PrimeBuild-pc/MouseLatencyTester/docs/images/README.md

# Screenshots

Place interface screenshots here and reference them from the main `README.md`.

Suggested set (generate them with **Settings → Demo mode → Start demo device**
so no hardware is needed and no real data is exposed):

| File | Content |
|---|---|
| `live-dark.png` | Live test tab, dark theme, mid-run |
| `live-light.png` | Live test tab, light theme |
| `testmode-green.png` | Full-screen test mode, armed state |
| `compare-box.png` | Compare tab, box plot of 4 polling rates |
| `compare-ecdf.png` | Compare tab, ECDF |
| `sessions.png` | Archive with search |
| `wiring.jpg` | Photo of the actual probe setup |

Keep them under ~500 KB each.
