PrimeBuild-pc/MouseLatencyTester/docs/hardware/teensy20-dimensions.png

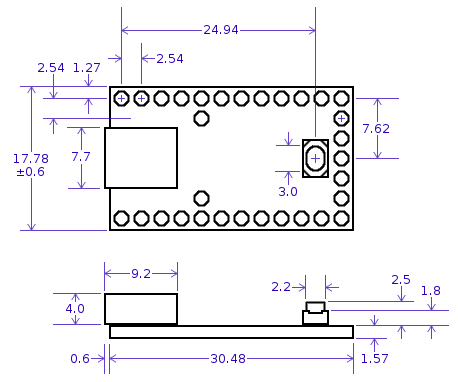
docs/hardware/teensy20-dimensions.png
