PrimeBuild-pc/MouseLatencyTester/docs/images/hardware/pcb-a1b-bottom.png

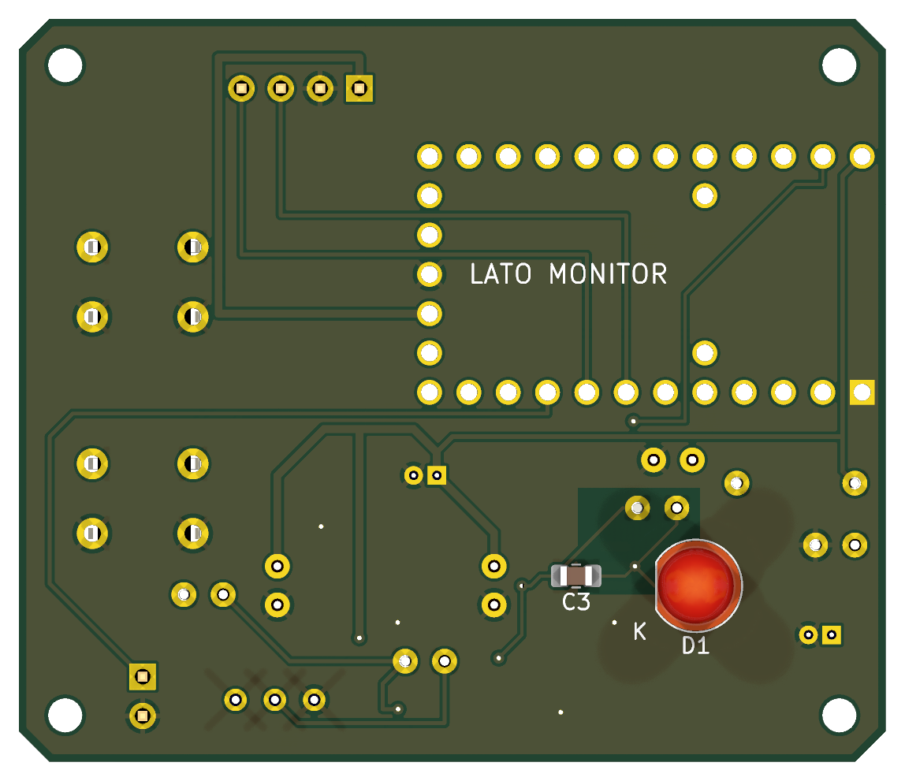
docs/images/hardware/pcb-a1b-bottom.png
