PrimeBuild-pc/MouseLatencyTester/docs/images/hardware/pcb-a1b-top.png

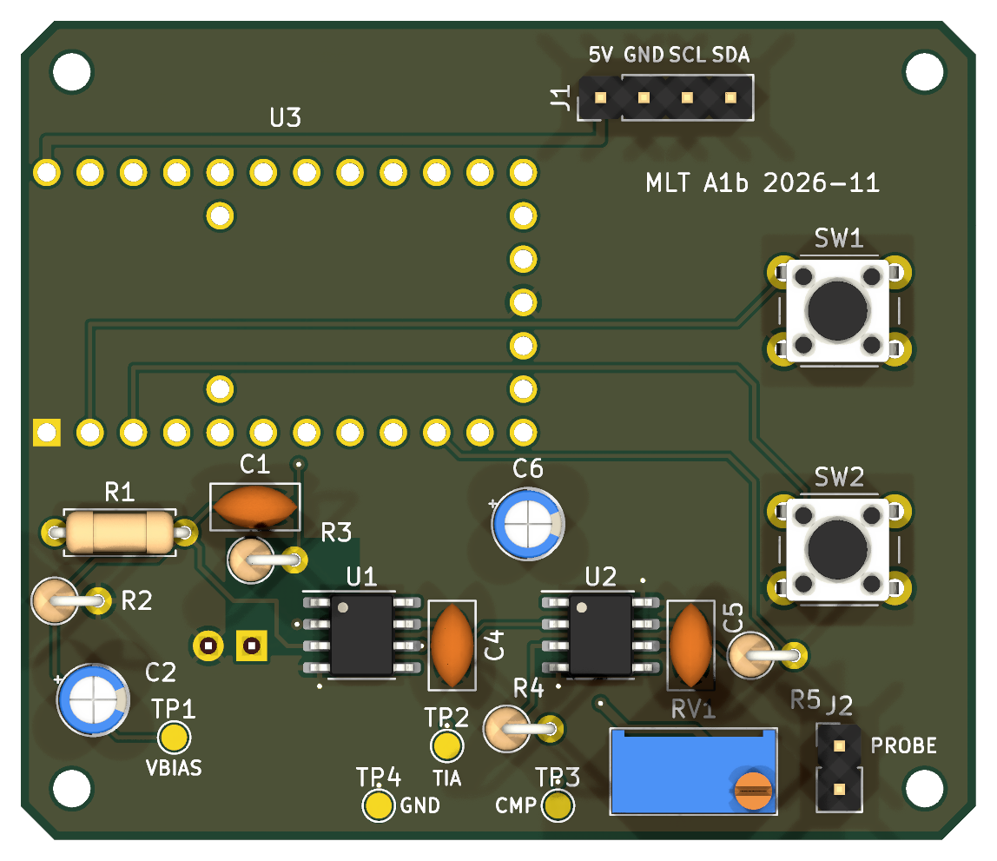
docs/images/hardware/pcb-a1b-top.png
