PrimeBuild-pc/MouseLatencyTester/hardware/compact/board-first.png

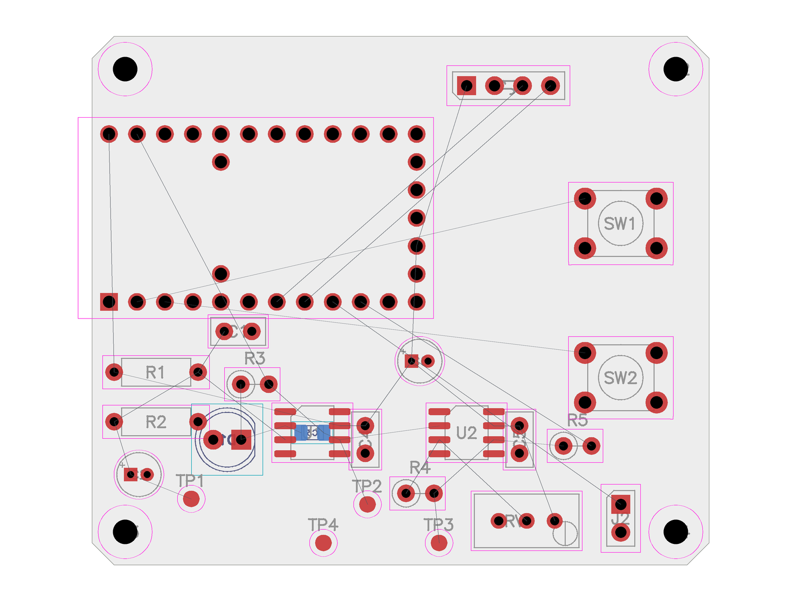
hardware/compact/board-first.png
