PrimeBuild-pc/MouseLatencyTester/hardware/compact/board-top.png

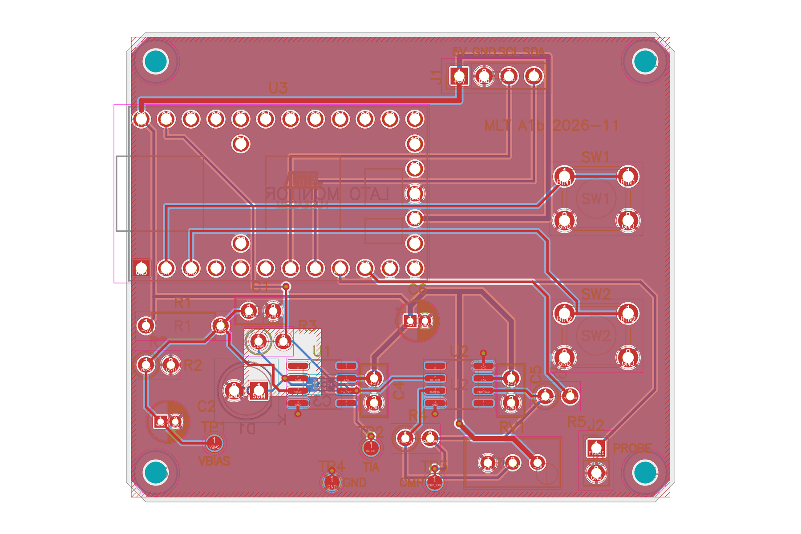
hardware/compact/board-top.png
