PrimeBuild-pc/MouseLatencyTester/hardware/compact/gerber-bottom.png

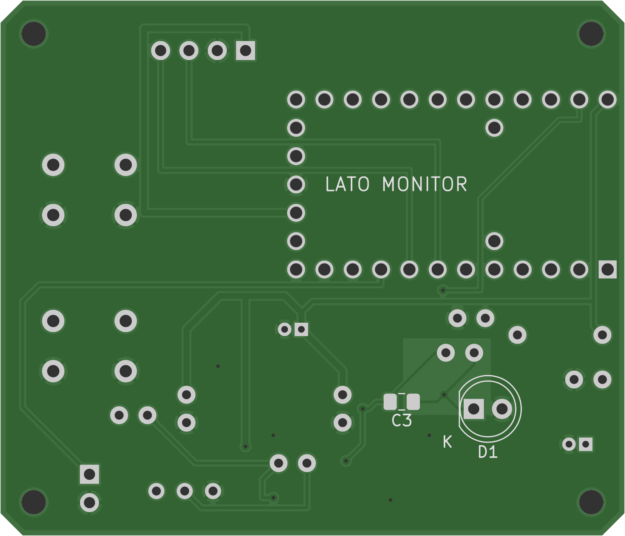
hardware/compact/gerber-bottom.png
