PrimeBuild-pc/MouseLatencyTester/hardware/compact/placement.png

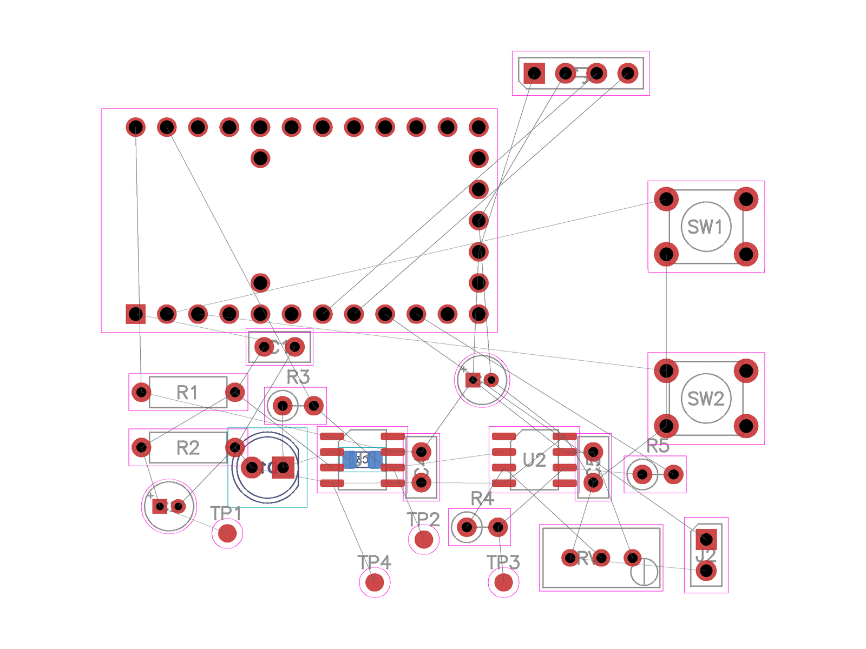
hardware/compact/placement.png
