PrimeBuild-pc/MouseLatencyTester/hardware/compact/preview-complete.png

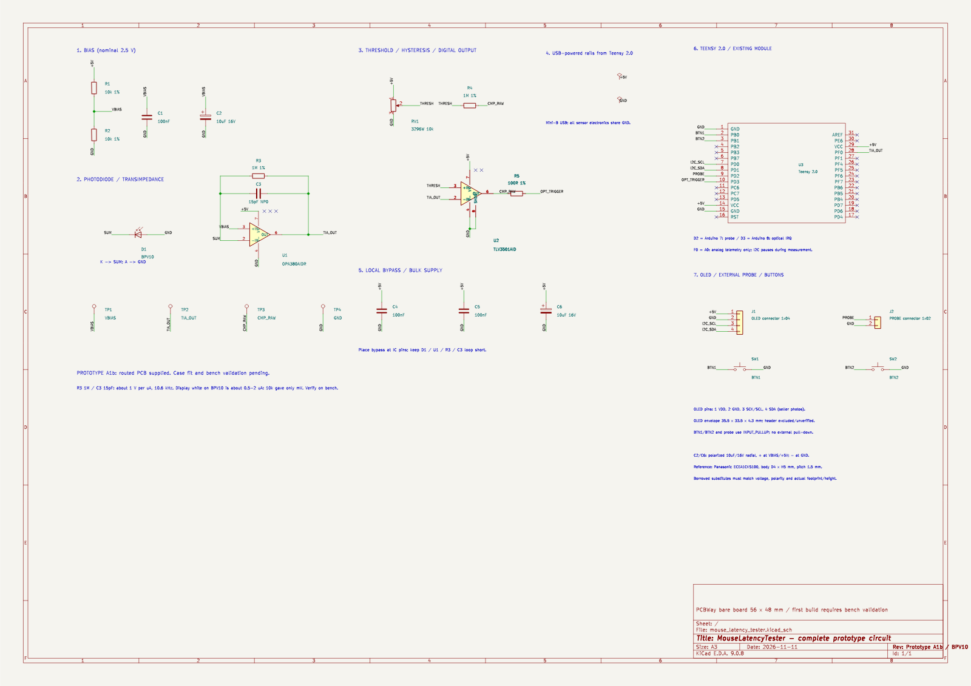
hardware/compact/preview-complete.png
