PrimeBuild-pc/MouseLatencyTester/hardware/optical-front-end/preview.png

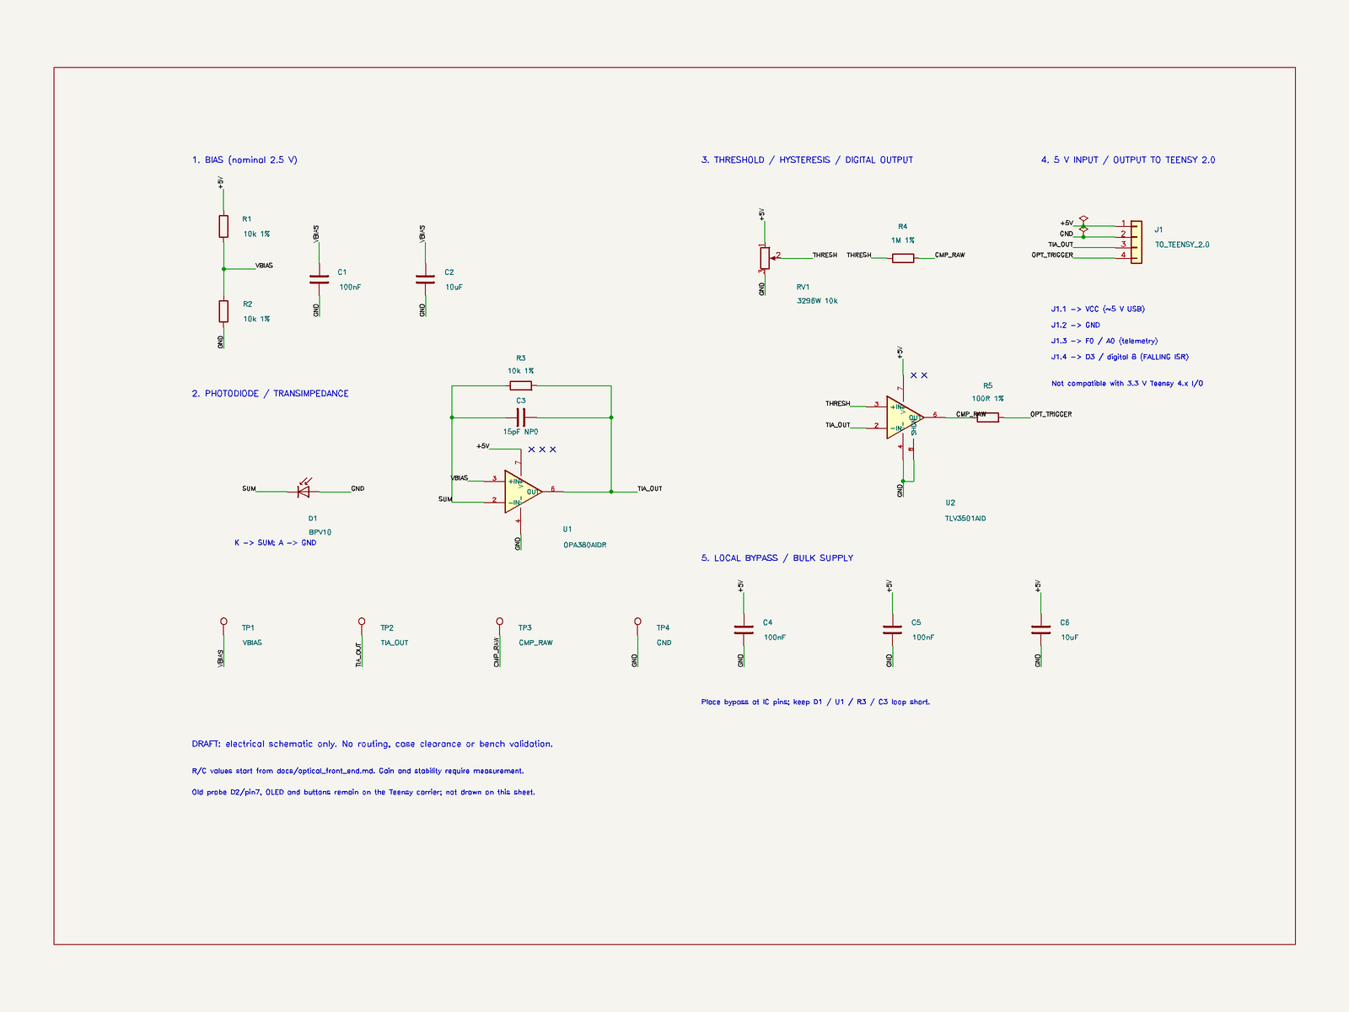
hardware/optical-front-end/preview.png
