PrimeBuild-pc/MouseLatencyTester/hardware/compact/mechanical/mouse_latency_tester.step

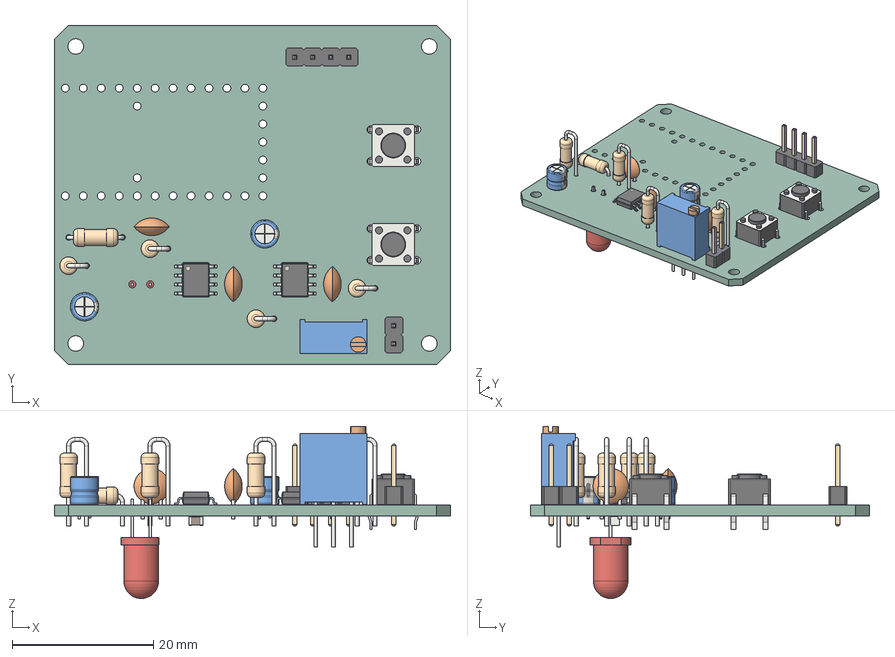
[picture p25: CAD file, 2026-11-11]
hardware/compact/mechanical/mouse_latency_tester.step
56.0 x 48.0 x 24.3 mm
C_Disc_D50mm_W25mm_P250mm x 3
R_Axial_DIN0207_L63mm_D25mm_P762mm_Horizontal
SW_PUSH_6mm_h4.3mm x 2
SOIC-8_3.9x4.9mm_P1.27mm x 2
R_Axial_DIN0207_L63mm_D25mm_P254mm_Vertical x 4
PinHeader_1x02_P254mm_Vertical
CP_Radial_D40mm_P150mm x 2
PinHeader_1x04_P254mm_Vertical
Potentiometer_Bourns_3296W_Vertical
LED_D5.0mm
C_0805_2012Metric
mouse_latency_tester_PCB
