PrimeBuild-pc/MouseLatencyTester/outputs/MouseLatencyTester-A1/Delivery-A1/Mechanical/mouse_latency_tester-outline.dxf

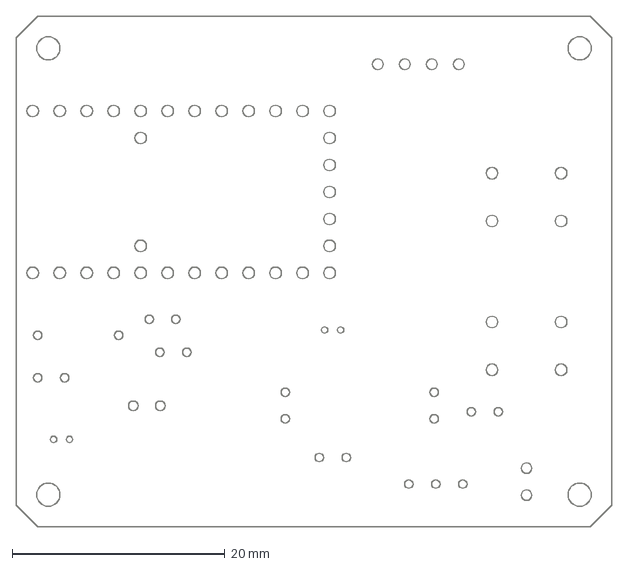
[picture p26: CAD file, 2026-11-11]
outputs/MouseLatencyTester-A1/Delivery-A1/Mechanical/mouse_latency_tester-outline.dxf
56.0 x 48.0 mm
