PrimeBuild-pc/MouseLatencyTester/outputs/MouseLatencyTester-A1/Delivery-A1/Previews/assembly-top.png

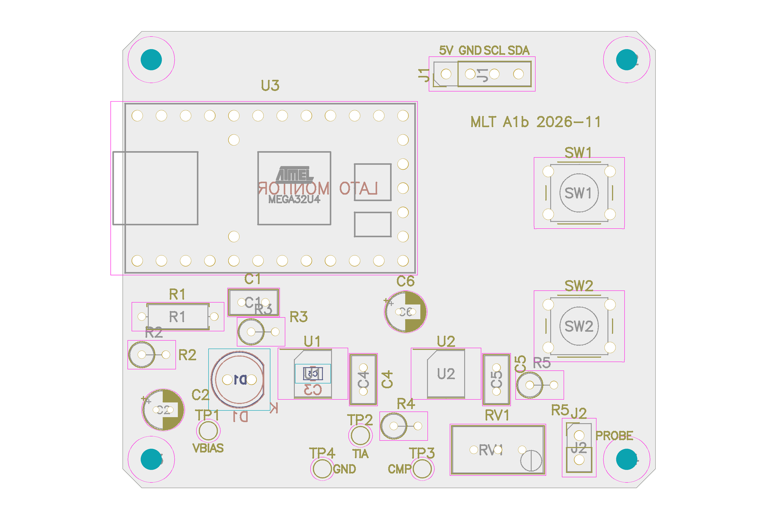
outputs/MouseLatencyTester-A1/Delivery-A1/Previews/assembly-top.png
