PrimeBuild-pc/MouseLatencyTester/hardware/compact/mouse_latency_tester.kicad_pcb

## KiCad design hardware/compact/mouse_latency_tester.kicad_pcb (2026-11-11)

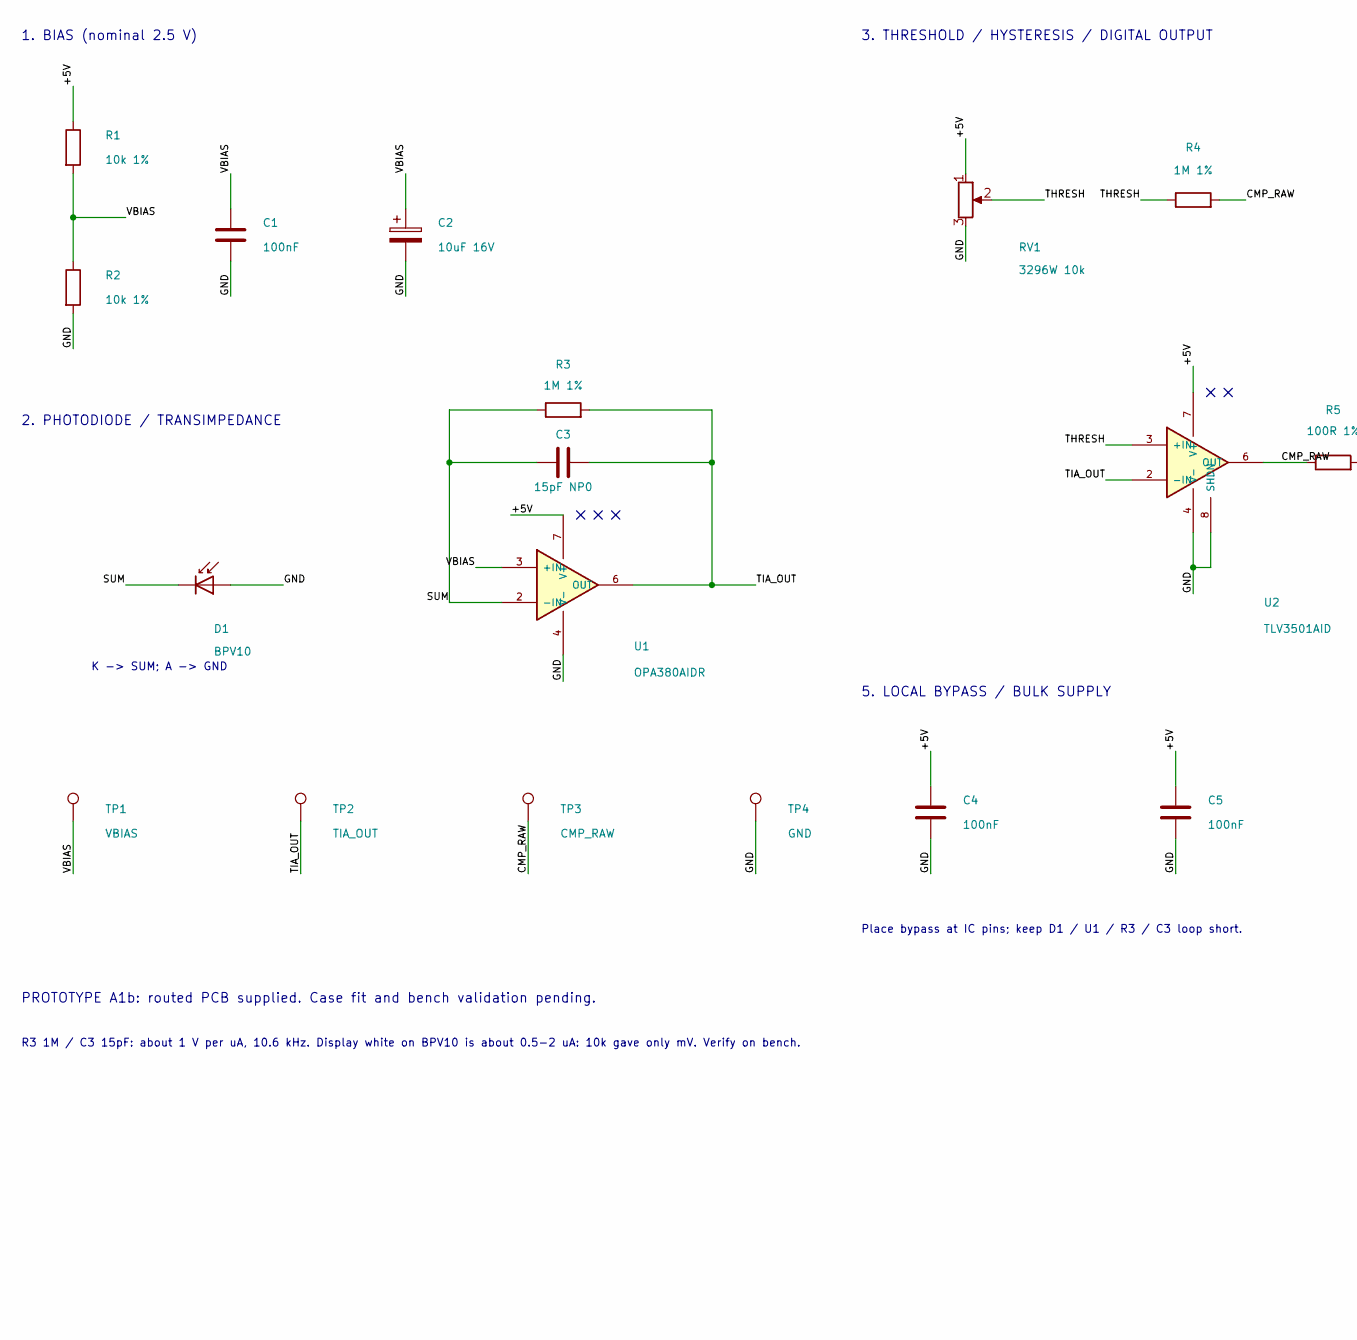
[picture p29: schematic mouse_latency_tester.kicad_sch, MouseLatencyTester - complete prototype circuit, part in row 1, column 1]

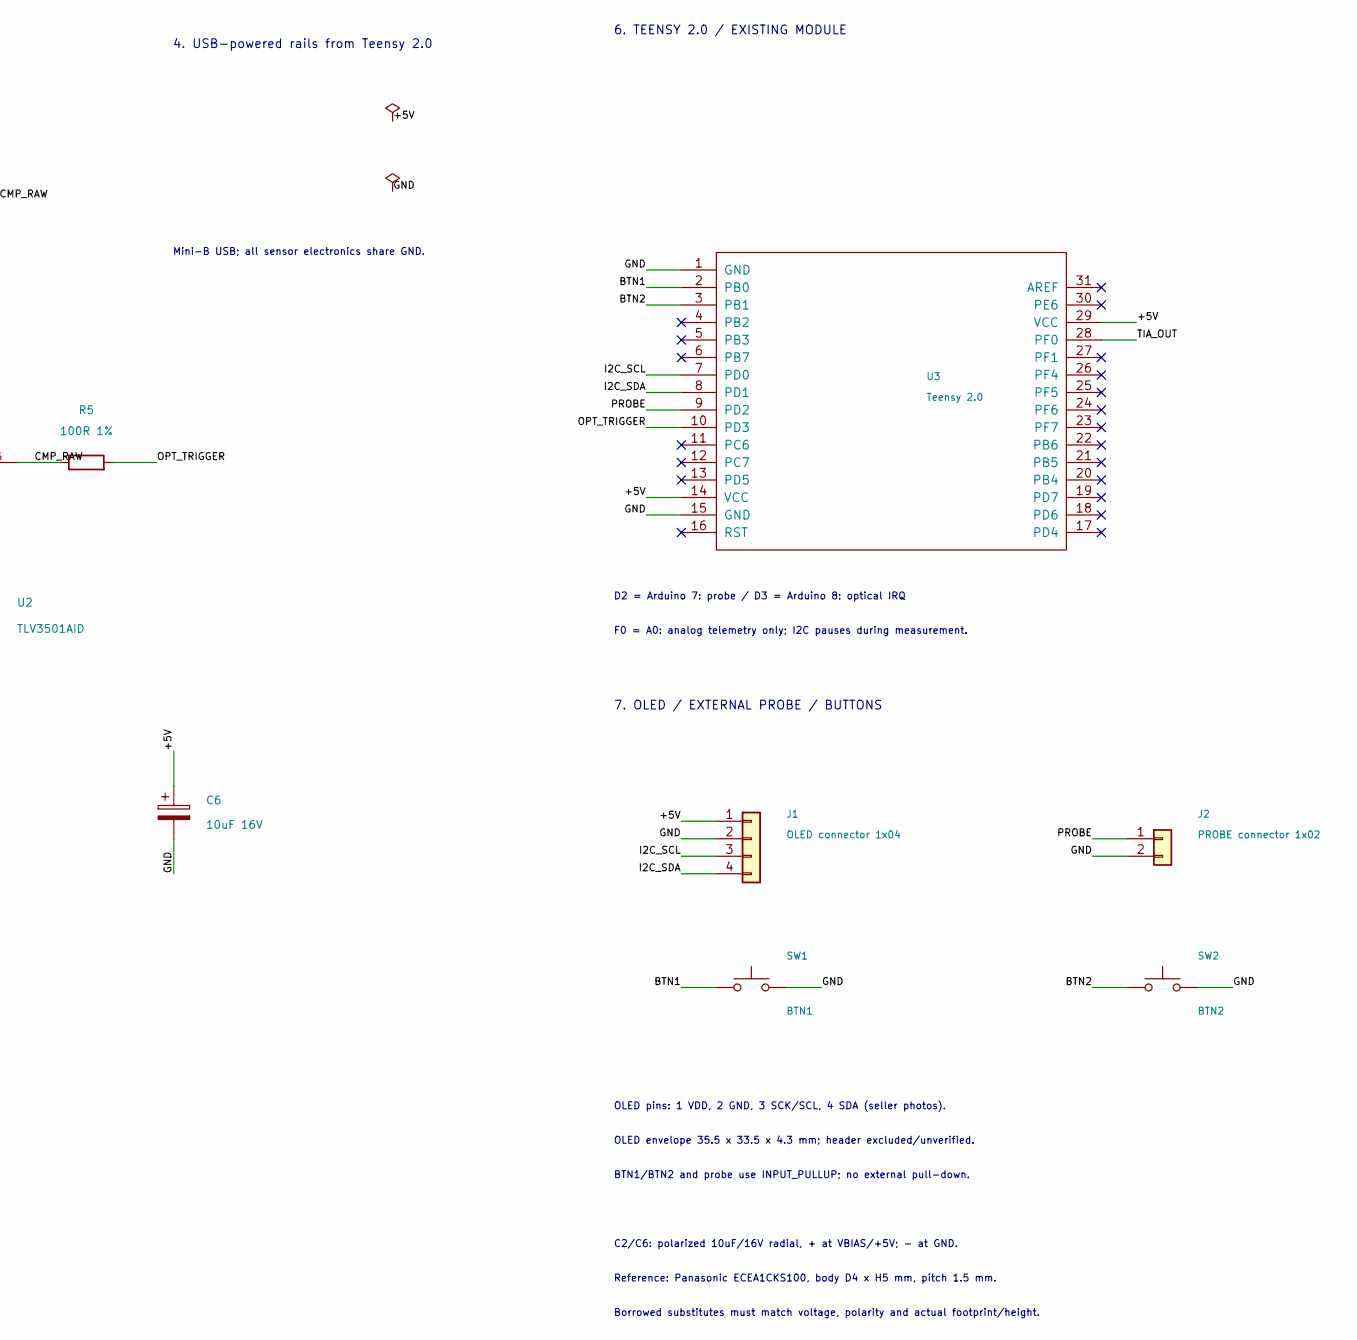
[picture p30: schematic mouse_latency_tester.kicad_sch, MouseLatencyTester - complete prototype circuit, part in row 1, column 2]

Parts:
C1, C4, C5: 100nF; C_Disc_D5.0mm_W2.5mm_P2.50mm
C2, C6: 10uF 16V; CP_Radial_D4.0mm_P1.50mm; MPN ECEA1CKS100
C3: 15pF NP0; C_0805_2012Metric_Pad1.18x1.45mm_HandSolder
D1: BPV10; LED_D5.0mm; MPN BPV10
J1: OLED connector 1x04; PinHeader_1x04_P2.54mm_Vertical
J2: PROBE connector 1x02; PinHeader_1x02_P2.54mm_Vertical
R1: 10k 1%; R_Axial_DIN0207_L6.3mm_D2.5mm_P7.62mm_Horizontal
R2: 10k 1%; R_Axial_DIN0207_L6.3mm_D2.5mm_P2.54mm_Vertical
R3, R4: 1M 1%; R_Axial_DIN0207_L6.3mm_D2.5mm_P2.54mm_Vertical
R5: 100R 1%; R_Axial_DIN0207_L6.3mm_D2.5mm_P2.54mm_Vertical
RV1: 3296W 10k; Potentiometer_Bourns_3296W_Vertical
SW1: BTN1; SW_PUSH_6mm_H4.3mm
SW2: BTN2; SW_PUSH_6mm_H4.3mm
TP1: VBIAS; TestPoint_Pad_D1.5mm
TP2: TIA_OUT; TestPoint_Pad_D1.5mm
TP3: CMP_RAW; TestPoint_Pad_D1.5mm
TP4: GND; TestPoint_Pad_D1.5mm
U1: OPA380AIDR; SOIC-8_3.9x4.9mm_P1.27mm; MPN OPA380AIDR
U2: TLV3501AID; SOIC-8_3.9x4.9mm_P1.27mm; MPN TLV3501AID
U3: Teensy 2.0; Teensy2.0; MPN Teensy 2.0

Connections:
/+5V: C4.1, C5.1, C6.1, J1.1, R1.1, RV1.1, U1.7 (V+), U2.7 (V+), U3.14 (VCC), U3.29 (VCC)
/BTN1: SW1.1, U3.2 (PB0)
/BTN2: SW2.1, U3.3 (PB1)
/CMP_RAW: R4.2, R5.1, TP3.1 (1_1), U2.6 (OUT)
/GND: C1.2, C2.2, C4.2, C5.2, C6.2, D1.2 (A), J1.2, J2.2, R2.2, RV1.3, SW1.2, SW2.2, TP4.1 (1_1), U1.4 (V-), U2.4 (V-), U2.8 (SHDN), U3.1 (GND), U3.15 (GND)
/I2C_SCL: J1.3, U3.7 (PD0)
/I2C_SDA: J1.4, U3.8 (PD1)
/OPT_TRIGGER: R5.2, U3.10 (PD3)
/PROBE: J2.1, U3.9 (PD2)
/SUM: C3.1, D1.1 (K), R3.1, U1.2 (-IN)
/THRESH: R4.1, RV1.2, U2.3 (+IN)
/TIA_OUT: C3.2, R3.2, TP2.1 (1_1), U1.6 (OUT), U2.2 (-IN), U3.28 (PF0)
/VBIAS: C1.1, C2.1, R1.2, R2.1, TP1.1 (1_1), U1.3 (+IN)

Notes on the sheet:
1. BIAS (nominal 2.5 V)
2. PHOTODIODE / TRANSIMPEDANCE
K -> SUM; A -> GND
3. THRESHOLD / HYSTERESIS / DIGITAL OUTPUT
5. LOCAL BYPASS / BULK SUPPLY
Place bypass at IC pins; keep D1 / U1 / R3 / C3 loop short.
PROTOTYPE A1b: routed PCB supplied. Case fit and bench validation pending.
R3 1M / C3 15pF: about 1 V per uA, 10.6 kHz. Display white on BPV10 is about 0.5-2 uA: 10k gave only mV. Verify on bench.
4. USB-powered rails from Teensy 2.0
Mini-B USB; all sensor electronics share GND.
6. TEENSY 2.0 / EXISTING MODULE
D2 = Arduino 7: probe / D3 = Arduino 8: optical IRQ
F0 = A0: analog telemetry only; I2C pauses during measurement.
7. OLED / EXTERNAL PROBE / BUTTONS
OLED pins: 1 VDD, 2 GND, 3 SCK/SCL, 4 SDA (seller photos).
OLED envelope 35.5 x 33.5 x 4.3 mm; header excluded/unverified.
BTN1/BTN2 and probe use INPUT_PULLUP; no external pull-down.
C2/C6: polarized 10uF/16V radial, + at VBIAS/+5V; - at GND.
Reference: Panasonic ECEA1CKS100, body D4 x H5 mm, pitch 1.5 mm.
Borrowed substitutes must match voltage, polarity and actual footprint/height.

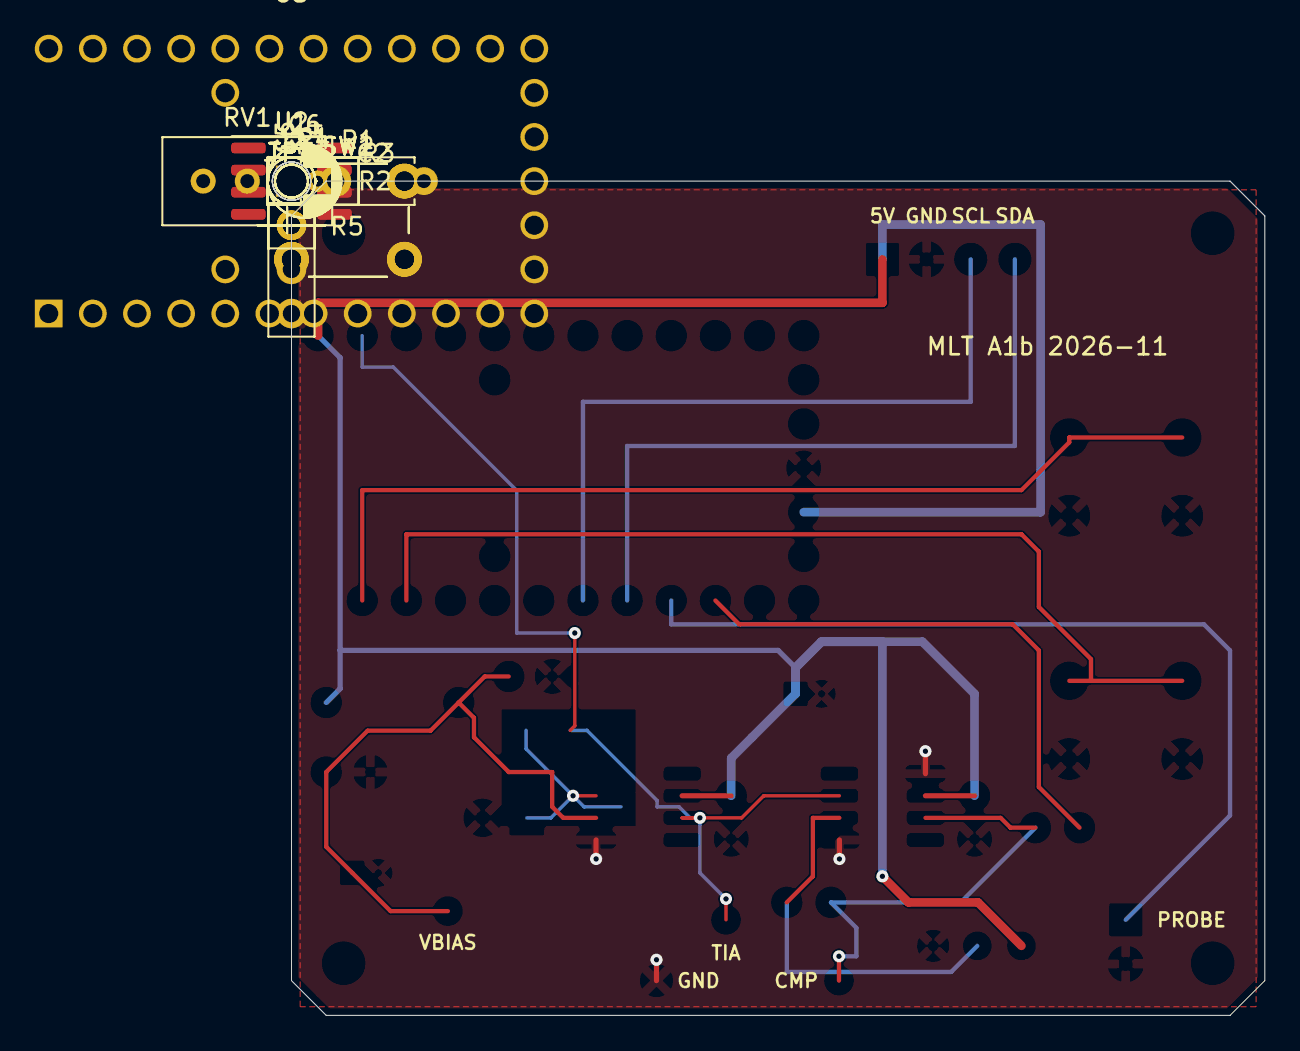
[picture p31: board mouse_latency_tester.kicad_pcb from above]

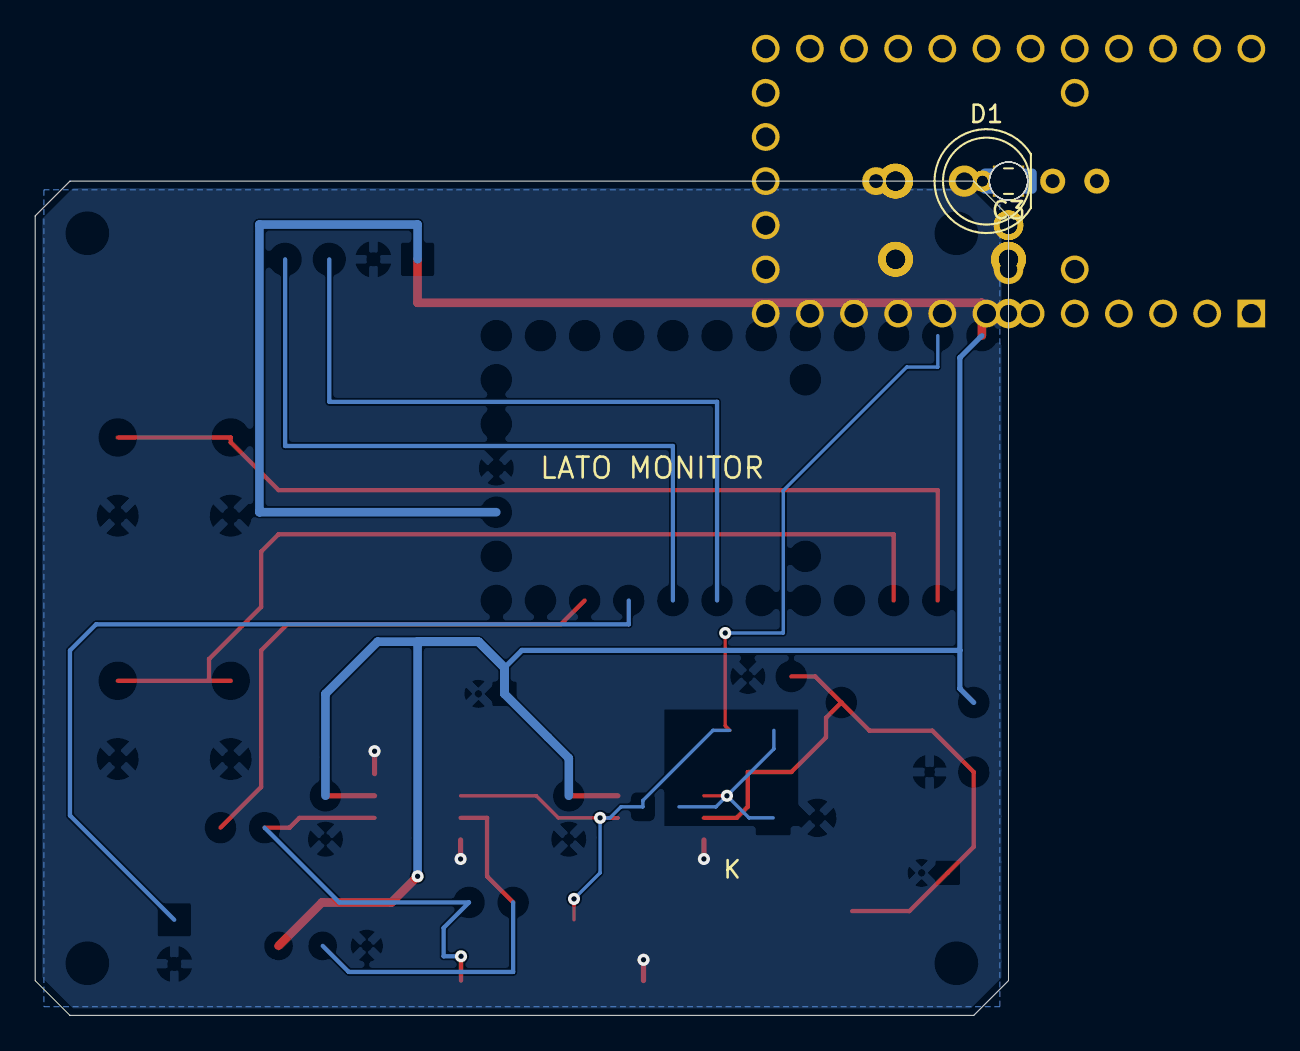
[picture p32: board mouse_latency_tester.kicad_pcb from below]

Board: 2 copper layers, 56.0 x 48.0 mm, 28 parts (2 on the bottom side), 13 nets.

Other parts of the board:
H1, H2, H3, H4: MountingHole_2.2mm_M2
