PrimeBuild-pc/MouseLatencyTester/latency_tester/app.py

"""Application shell: owns the services, the state and the event pump.

Threading rule: only this module's ``_pump`` touches tkinter.  The serial
reader thread and the mouse callback communicate exclusively through the event
queue in :mod:`latency_tester.serial_service`.
"""

from __future__ import annotations

import logging
import queue
import tkinter as tk
from datetime import datetime
from tkinter import filedialog, messagebox, ttk

from . import SUPPORTED_FIRMWARE, __version__, export, protocol, serial_service, theme
from .constants import (FRAME_CAP_AUTO, FRAME_CAP_FALLBACK, MEASUREMENT_MODES,
                        MODE_PHOTON, MODE_PROBE_PC)
from .database import LatencyDB
from .demo import PORT_NAME as DEMO_PORT
from .demo import DemoDevice
from .i18n import translator as tr
from .settings import Settings
from .stats import compute_stats, fmt_ms

log = logging.getLogger(__name__)

PUMP_INTERVAL_MS = 50
LIGHT_POLL_MS = 1000
#: Faster reading while the optical calibration target is showing.
LIGHT_AIM_POLL_MS = 150
#: How long to let the LDR settle after the target changes colour, before a
#: baseline is sampled.  A photoresistor is slow; this is not a guess to tune
#: away, it is the sensor's own response time.
OPTICAL_SETTLE_MS = 400
#: The optical calibration, in order: (target is bright, command to send).
PHOTON_CALIBRATION_STEPS = (
    (False, protocol.CMD_CAL_DARK),
    (True, protocol.CMD_CAL_BRIGHT),
)
RECONNECT_INTERVAL_MS = 3000

class LatencyTesterApp:
    def __init__(self, root: tk.Tk):
        self.root = root

        self.settings = Settings()
        tr.set_language(self.settings.get("language"))
        self.palette = theme.resolve(self.settings.get("theme"))

        self.db = LatencyDB(self.settings.db_path)
        if not self.db.list_devices():
            self.db.create_device(name="Mouse")

        self.serial = serial_service.SerialService()
        self.serial.accept_trig = self._accept_trig
        self.mouse = serial_service.MouseWatcher(self.serial.clicks)
        self.mouse.start()

        self.running = True
        self.test_mode = False
        self.test_complete = False
        self.overlay = None
        self.cal_window = None
        self._reconnect_port: str | None = None

        # Current, unsaved run.
        self.current_samples: list[dict] = []
        self.session_saved = False
        self.run_started_at: str | None = None
        self.run_ended_at: str | None = None
        self.test_start_index = 0
        self.current_light: int | None = None
        self.light_start: int | None = None
        self.light_end: int | None = None
        self._awaiting_light_end = False

        self._build_vars()
        self._build_shell()

        self.auto_select_device()
        self.refresh_ports(auto_connect=bool(self.settings.get("auto_connect")))
        # Tracked so shutdown can cancel them; a callback firing after the
        # interpreter is gone raises "invalid command name" out of Tk itself.
        self._timers = {
            "pump": self.root.after(PUMP_INTERVAL_MS, self._pump),
            "light": self.root.after(LIGHT_POLL_MS, self._poll_light),
            "watch": self.root.after(RECONNECT_INTERVAL_MS, self._watch_connection),
        }
        self.root.protocol("WM_DELETE_WINDOW", self.close)

    # ================================================================ state ==
    def _build_vars(self) -> None:
        s = self.settings
        self.port_var = tk.StringVar()
        self.connection_var = tk.StringVar(value=tr("conn.disconnected"))
        self.firmware_var = tk.StringVar(value="—")
        self.state_var = tk.StringVar(value="READY")
        self.cal_var = tk.StringVar(value="0 µs")
        self.light_var = tk.StringVar(value="—")
        self.skipped_var = tk.StringVar(value="0")
        # Firmware v1.4 button test: counters make "10 presses -> 10 events"
        # verifiable at a glance.
        self.button_counts = {1: 0, 2: 0}
        self.button_vars = {1: tk.StringVar(value="0"), 2: tk.StringVar(value="0")}

        self.metric_vars = {
            key: tk.StringVar(value="—")
            for key in ("last", "mean", "median", "min", "max", "stdev",
                        "p5", "p95", "p99", "iqr", "mad", "jitter")
        }
        self.metric_vars["n"] = tk.StringVar(value="0")
        self.outlier_var = tk.StringVar(value="")

        self.device_var = tk.StringVar()
        self.run_name_var = tk.StringVar()
        self.polling_var = tk.StringVar(value=str(s.get("last_polling_rate")))
        self.mode_var = tk.StringVar(value=str(s.get("last_connection_mode")))
        self.dpi_var = tk.StringVar(value=str(s.get("last_dpi") or ""))
        self.mouse_fw_var = tk.StringVar()
        self.debounce_var = tk.StringVar()
        self.notes_var = tk.StringVar()
        self.target_var = tk.IntVar(value=int(s.get("target_samples") or 50))
        self.auto_reset_var = tk.BooleanVar(value=bool(s.get("auto_reset_on_test")))

        self.language_var = tk.StringVar(value=tr.language)
        self.theme_var = tk.StringVar(value=str(s.get("theme")))
        self.auto_connect_var = tk.BooleanVar(value=bool(s.get("auto_connect")))
        self.confirm_btn2_var = tk.BooleanVar(value=bool(s.get("confirm_btn2_reset")))

        # Probe-to-Photon.  The mode is a plain string so it can go straight
        # into the archive; MEASUREMENT_MODES is the only accepted vocabulary.
        mode = s.get("measurement_mode")
        self.measure_mode_var = tk.StringVar(
            value=mode if mode in MEASUREMENT_MODES else MODE_PROBE_PC)
        self.optical_dark: int | None = None
        self.optical_bright: int | None = None
        self.optical_threshold: int | None = None
        self.optical_rising = True
        self.opt_dark_var = tk.StringVar(value="—")
        self.opt_bright_var = tk.StringVar(value="—")
        self.opt_threshold_var = tk.StringVar(value="—")
        self.opt_status_var = tk.StringVar(value=tr("photon.status_uncalibrated"))
        # Frame cap for the optical target.  FRAME_CAP_AUTO means "whatever the
        # monitor is running at", resolved when a test starts rather than now:
        # the user may move the window to another screen in between.
        self.frame_cap = _as_int(s.get("frame_cap"), FRAME_CAP_AUTO)
        self.frame_cap_var = tk.StringVar()

        self.device_name_to_id: dict[str, int] = {}

    # ================================================================ shell ==
    def _build_shell(self) -> None:
        theme.apply(self.root, self.palette)
        self.root.title(f"{tr('app.title')} v{__version__}")
        geometry = str(self.settings.get("window_geometry") or "")
        self.root.geometry(geometry if geometry else "1380x900")
        self.root.minsize(1024, 680)

        self.shell = ttk.Frame(self.root, padding=12)
        self.shell.pack(fill="both", expand=True)

        self._build_connection_bar(self.shell)

        self.demo_banner = ttk.Label(self.shell, text=tr("app.demo_banner"),
                                     style="Demo.TLabel")
        # packed/unpacked by _update_connection_labels

        self.notebook = ttk.Notebook(self.shell)
        self.notebook.pack(fill="both", expand=True, pady=(10, 0))

        from .views.compare import CompareView
        from .views.devices import DevicesView
        from .views.live import LiveView
        from .views.preferences import PreferencesView
        from .views.sessions import SessionsView

        self.live_view = LiveView(self.notebook, self)
        self.sessions_view = SessionsView(self.notebook, self)
        self.compare_view = CompareView(self.notebook, self)
        self.devices_view = DevicesView(self.notebook, self)
        self.preferences_view = PreferencesView(self.notebook, self)

        self.notebook.add(self.live_view, text=tr("tab.live"))
        self.notebook.add(self.sessions_view, text=tr("tab.sessions"))
        self.notebook.add(self.compare_view, text=tr("tab.compare"))
        self.notebook.add(self.devices_view, text=tr("tab.devices"))
        self.notebook.add(self.preferences_view, text=tr("tab.settings"))

        self.refresh_devices()
        self.refresh_sessions()
        self._update_metrics()
        self._update_connection_labels()

    def _build_connection_bar(self, parent: ttk.Frame) -> None:
        bar = ttk.LabelFrame(parent, text=f" {tr('conn.title')} ", padding=10)
        bar.pack(fill="x")

        ttk.Label(bar, text=tr("conn.port")).pack(side="left")
        self.port_combo = ttk.Combobox(bar, textvariable=self.port_var,
                                       width=34, state="readonly")
        self.port_combo.pack(side="left", padx=(8, 8))
        ttk.Button(bar, text=tr("conn.refresh"),
                   command=lambda: self.refresh_ports(False)).pack(side="left", padx=3)
        self.connect_btn = ttk.Button(bar, text=tr("conn.connect"),
                                      command=self.toggle_connection,
                                      style="Accent.TButton")
        self.connect_btn.pack(side="left", padx=3)

        ttk.Separator(bar, orient="vertical").pack(side="left", fill="y", padx=14)
        ttk.Label(bar, text=tr("conn.status")).pack(side="left", padx=(0, 6))
        self.connection_label = ttk.Label(bar, textvariable=self.connection_var,
                                          style="Error.TLabel")
        self.connection_label.pack(side="left")
        ttk.Label(bar, text=tr("conn.firmware"),
                  style="Muted.TLabel").pack(side="left", padx=(16, 6))
        ttk.Label(bar, textvariable=self.firmware_var).pack(side="left")

        ttk.Label(bar, text=f"{tr('conn.archive')}: {self.db.path}",
                  style="Muted.TLabel").pack(side="right")

    def rebuild_ui(self) -> None:
        """Re-create the interface after a theme or language change."""
        if self.test_mode:
            return
        self.settings.save()
        self.palette = theme.resolve(self.settings.get("theme"))
        self.shell.destroy()
        self._build_shell()
        self.live_view.set_samples(self._latencies())
        self._update_metrics()

    # =========================================================== connection ==
    def refresh_ports(self, auto_connect: bool = False) -> None:
        ports = serial_service.list_ports()
        labels = [p["label"] for p in ports]
        labels.append(DEMO_PORT)
        self.port_combo["values"] = labels

        detected = next((p["label"] for p in ports if p["is_teensy"]), None)
        if detected:
            self.port_var.set(detected)
        elif not self.port_var.get() and labels:
            self.port_var.set(labels[0])

        if auto_connect and detected and not self.serial.connected:
            self.root.after(250, lambda: self._auto_connect(attempts=4))

    def _auto_connect(self, attempts: int) -> None:
        """Connect at startup without ever blocking the user with a dialog.

        Windows can still be holding the COM port for a moment after a previous
        run of the dashboard, so the automatic attempt is retried quietly
        instead of greeting the user with an access error.
        """
        if not self.running or self.serial.connected:
            return
        if self.connect(silent=True):
            return
        if attempts > 1:
            self.root.after(700, lambda: self._auto_connect(attempts - 1))

    def _selected_port(self) -> str:
        value = self.port_var.get().strip()
        return value.split(" — ", 1)[0].strip()

    def toggle_connection(self) -> None:
        self.disconnect() if self.serial.connected else self.connect()

    def connect(self, silent: bool = False) -> bool:
        """Open the selected port.  Returns whether the dashboard is connected.

        ``silent`` suppresses the error dialogs: an automatic attempt reports
        by returning False, only a user-initiated one interrupts with a modal.
        """
        if self.serial.connected:
            return True
        device = self._selected_port()
        if not device:
            if not silent:
                messagebox.showwarning(tr("conn.title"), tr("conn.no_port"))
            return False

        if device == DEMO_PORT:
            self.serial.attach(DemoDevice(), DEMO_PORT, is_demo=True)
            self.log(tr("log.demo_on"))
        else:
            try:
                transport = serial_service.open_serial(device)
            except Exception as exc:
                if not silent:
                    messagebox.showerror(tr("conn.open_failed_title"),
                                         tr("conn.open_failed", error=exc))
                return False
            self.serial.attach(transport, device)
            self.log(tr("log.connected", port=device))
            self._reconnect_port = device

        self._update_connection_labels()
        for delay, command in ((400, protocol.CMD_VERSION),
                               (650, protocol.CMD_STATS),
                               (900, protocol.CMD_LIGHT),
                               (1150, protocol.CMD_CAL_REPORT)):
            self.root.after(delay, lambda c=command: self.serial.send(c))
        return True

    def disconnect(self, keep_retrying: bool = False) -> None:
        was_demo = self.serial.is_demo
        self.serial.close()
        if not keep_retrying:
            self._reconnect_port = None
        if was_demo:
            self.log(tr("log.demo_off"))
        self.firmware_var.set("—")
        self._update_connection_labels()

    def _update_connection_labels(self) -> None:
        connected = self.serial.connected
        if connected and self.serial.is_demo:
            self.connection_var.set(tr("conn.demo"))
            self.connection_label.configure(style="Warn.TLabel")
        elif connected:
            self.connection_var.set(f"{tr('conn.connected')} — {self.serial.port_name}")
            self.connection_label.configure(style="Ok.TLabel")
        else:
            self.connection_var.set(tr("conn.disconnected"))
            self.connection_label.configure(style="Error.TLabel")

        self.connect_btn.configure(
            text=tr("conn.disconnect") if connected else tr("conn.connect"))

        if self.is_demo and not self.demo_banner.winfo_ismapped():
            self.demo_banner.pack(fill="x", pady=(10, 0), before=self.notebook)
        elif not self.is_demo and self.demo_banner.winfo_ismapped():
            self.demo_banner.pack_forget()

        self.live_view.set_connected(connected)

    def _watch_connection(self) -> None:
        """Reopen a port that came back after a cable hiccup.

        Runs on the Tk thread, so it can never race the reader thread; the
        current run's samples are kept either way.
        """
        if (self.running and self._reconnect_port and not self.serial.connected
                and self.auto_connect_var.get()):
            available = {p["device"] for p in serial_service.list_ports()}
            if self._reconnect_port in available:
                try:
                    transport = serial_service.open_serial(self._reconnect_port)
                except Exception:
                    transport = None
                if transport is not None:
                    self.serial.attach(transport, self._reconnect_port)
                    self.log(tr("conn.reconnected", port=self._reconnect_port))
                    self._update_connection_labels()
                    self.serial.send(protocol.CMD_VERSION)
        if self.running:
            self._timers["watch"] = self.root.after(
                RECONNECT_INTERVAL_MS, self._watch_connection)

    @property
    def is_demo(self) -> bool:
        return self.serial.connected and self.serial.is_demo

    # ============================================================== commands ==
    def send(self, command: str) -> bool:
        return self.serial.send(command)

    def calibrate(self) -> None:
        if not self.serial.connected or self.serial.calibrating or self.test_mode:
            return
        self.state_var.set("CALIBRATING")
        self.log(tr("log.calibrating"))
        if self.serial.start_calibration():
            self.root.after(800, self._calibration_ready)

    def _calibration_ready(self) -> None:
        if self.serial.connected and self.serial.calibrating:
            self.serial.send_calibration_ready()

    def reset_stats(self) -> None:
        if self.serial.connected and not self.test_mode:
            self.send(protocol.CMD_RESET)

    # =========================================================== photon mode ==
    @property
    def photon_mode(self) -> bool:
        return self.measure_mode_var.get() == MODE_PHOTON

    def set_measurement_mode(self, mode: str) -> None:
        """Switch between Probe-to-PC and Probe-to-Photon.

        The two are separate measurements, so changing mode starts a new run
        rather than appending optical samples to serial ones.
        """
        previous = self.measure_mode_var.get()
        if mode not in MEASUREMENT_MODES or mode == previous:
            return
        if self.test_mode:
            self.measure_mode_var.set(previous)     # put the radio back
            messagebox.showinfo(tr("photon.title"), tr("dlg.exit_test_first"))
            return
        unsaved = bool(self.current_samples) and not self.session_saved
        if unsaved and not messagebox.askyesno(tr("photon.title"),
                                               tr("dlg.discard_confirm")):
            self.measure_mode_var.set(previous)
            return
        self.measure_mode_var.set(mode)
        self.settings.set("measurement_mode", mode)
        self.clear_samples()
        self.run_started_at = None
        self.run_ended_at = None
        self.log(tr("log.mode", mode=tr(f"mode.{mode}")))
        if self.serial.connected and mode == MODE_PHOTON:
            self.send(protocol.CMD_CAL_REPORT)
        self.live_view.refresh_mode()

    def calibrate_optical(self) -> None:
        """Take both optical baselines, full-screen, on the centred target.

        One button, because there is only one correct way to do it: the two
        readings must come from the same patch of screen the measurement uses.
        """
        if (not self.serial.connected or self.test_mode
                or self.cal_window is not None):
            return
        from .views.testmode import OpticalCalibrationWindow
        self.cal_window = OpticalCalibrationWindow(self.root, self)
        if not self.photon_mode:
            self.send(protocol.CMD_PHOTON_ON)
        self.root.after(300, lambda: self._photon_calibration_step(0))

    def retry_optical_calibration(self) -> None:
        """Re-run the sequence without closing the window, so the live reading
        stays on screen while the sensor is being aimed."""
        if self.cal_window is None:
            return
        self._photon_calibration_step(0)

    def cancel_optical_calibration(self) -> None:
        """Close the calibration window, whether it finished or was escaped."""
        if self.cal_window is None:
            return
        self.cal_window.close()
        self.cal_window = None
        self.live_view.refresh_mode()

    def _calibration_surface(self):
        """Whatever is showing the target right now: the test overlay during a
        run, the standalone window otherwise."""
        return self.overlay if self.test_mode else self.cal_window

    def monitor_hz(self) -> int | None:
        """Refresh rate of the display, or ``None`` when Windows will not say."""
        from . import devices as hardware
        return hardware.refresh_rate_hz()

    def effective_frame_cap(self) -> int:
        """The fps the optical target will actually be driven at.

        ``FRAME_CAP_AUTO`` resolves here, so a run always records a real number
        and an archived optical figure stays interpretable.
        """
        if self.frame_cap != FRAME_CAP_AUTO:
            return self.frame_cap
        return self.monitor_hz() or FRAME_CAP_FALLBACK

    def set_frame_cap(self, fps: int) -> None:
        if self.test_mode:
            return
        self.frame_cap = int(fps)
        self.settings.set("frame_cap", self.frame_cap)
        self.settings.save()
        # Keep the combobox in step whether the change came from it or not.
        self.live_view.refresh_frame_caps()
        self.log(tr("log.frame_cap", fps=self.effective_frame_cap()))

    def optical_ready(self) -> tuple[bool, str]:
        """Is the optical calibration good enough to start a test?

        Returns ``(ok, reason)``; the reason is already translated and is what
        the interface shows when it refuses to start.
        """
        if self.optical_dark is None or self.optical_bright is None:
            return False, tr("photon.status_uncalibrated")
        if protocol.optical_threshold(self.optical_dark, self.optical_bright) is None:
            # Say how far off it is: "too close" leaves you guessing whether the
            # setup is nearly right or nowhere near.
            return False, tr("photon.status_separation",
                             dark=self.optical_dark,
                             bright=self.optical_bright,
                             gap=abs(self.optical_bright - self.optical_dark),
                             minimum=protocol.OPTICAL_MIN_SEPARATION)
        return True, tr("photon.status_ready")

    def _apply_optical_cal(self, payload: dict) -> None:
        self.optical_dark = payload["dark"]
        self.optical_bright = payload["bright"]
        self.optical_threshold = payload["threshold"]
        self.optical_rising = payload["rising"]
        self.opt_dark_var.set(str(payload["dark"]))
        self.opt_bright_var.set(str(payload["bright"]))
        self.opt_threshold_var.set(str(payload["threshold"]))
        self.opt_status_var.set(self.optical_ready()[1])

    # ============================================================== buttons ==
    def _button_action(self, index: int) -> None:
        """Act on a physical button press.  The firmware only ever *reports*.

        The dashboard stays the authority on session state, so a press that
        would disturb a run is refused instead of obeyed.  The firmware already
        withholds button events between t0 and t1, so nothing can arrive here
        mid-measurement.
        """
        if not self.serial.connected or self.serial.calibrating:
            self.log(tr("log.button_refused"))
            return

        if index == 1:
            self.exit_test_mode() if self.test_mode else self.enter_test_mode()
        elif index == 2:
            # Never inside test mode: a stray press must not wipe a live run.
            if self.test_mode:
                self.log(tr("log.button_refused"))
                return
            needs_confirmation = bool(self.confirm_btn2_var.get()
                                      and self.current_samples)
            if needs_confirmation and not messagebox.askyesno(
                    tr("dlg.new_run"), tr("dlg.btn2_confirm")):
                self.log(tr("log.button_refused"))
                return
            # Same entry point the GUI Reset button and the keyboard use.
            self.reset_stats()

    # ============================================================= test mode ==
    def _accept_trig(self) -> bool:
        """Called from the serial thread: refuse new samples past the target."""
        return not (self.test_mode and self.test_complete)

    def enter_test_mode(self) -> None:
        if not self.serial.connected or self.overlay is not None:
            return

        target = self.target_samples()
        if not self.run_name_var.get().strip():
            self.run_name_var.set(self.generate_run_name())

        self.test_mode = True
        self.test_complete = False
        self.run_started_at = datetime.now().isoformat(timespec="seconds")
        self.run_ended_at = None
        self.light_start = self.current_light
        self.light_end = None
        self._awaiting_light_end = False
        self.session_saved = False
        self.test_start_index = 0 if self.auto_reset_var.get() else len(self.current_samples)

        from .views.testmode import TestModeOverlay
        self.overlay = TestModeOverlay(self.root, self, target)

        # Same ordering as the verified v2 flow: clear the firmware counters
        # first, then freeze the OLED.  In Probe-to-Photon the optical path is
        # selected last, once the display is already frozen.
        if self.auto_reset_var.get():
            self.send(protocol.CMD_RESET)
            self.root.after(180, self._start_firmware_test_mode)
        else:
            self._start_firmware_test_mode()

    def _start_firmware_test_mode(self) -> None:
        if not self.serial.connected:
            return
        self.send(protocol.CMD_TEST_MODE_ON)
        if self.photon_mode:
            self.root.after(80, self._arm_photon)

    def _arm_photon(self) -> None:
        if not self.serial.connected or not self.test_mode:
            return
        self.send(protocol.CMD_PHOTON_ON)
        # Calibrate on the real target, in the real overlay.  A baseline taken
        # from the side panel describes a different patch of screen -- different
        # backlight, and in test mode that spot is not even the target any more.
        self.root.after(240, lambda: self._photon_calibration_step(0))

    def _photon_calibration_step(self, index: int) -> None:
        """Walk the dark/bright baselines, then hand the target surface back."""
        surface = self._calibration_surface()
        if surface is None or not self.serial.connected:
            return
        if index >= len(PHOTON_CALIBRATION_STEPS):
            ok, reason = self.optical_ready()
            surface.finish_calibration(ok, reason)
            self.log(reason)
            return
        bright, command = PHOTON_CALIBRATION_STEPS[index]
        surface.show_calibrating(bright)
        # Paint first, sample only once the photoresistor has settled.
        self.root.after(OPTICAL_SETTLE_MS,
                        lambda: self._photon_calibration_sample(command, index))

    def _photon_calibration_sample(self, command: str, index: int) -> None:
        if self._calibration_surface() is None or not self.serial.connected:
            return
        self.send(command)
        # Let the OPT_CAL: reply arrive and be parsed before moving on.
        self.root.after(260, lambda: self._photon_calibration_step(index + 1))

    def exit_test_mode(self) -> None:
        was_active = self.test_mode
        self.test_mode = False
        self.test_complete = False
        self.run_ended_at = datetime.now().isoformat(timespec="seconds")

        if was_active and self.serial.connected:
            # Leave the optical path before the OLED comes back, so a stray
            # probe contact can never be measured with a half-torn-down state.
            if self.photon_mode:
                self.send(protocol.CMD_PHOTON_OFF)
            self.send(protocol.CMD_TEST_MODE_OFF)

        if self.overlay is not None:
            self.overlay.close()
            self.overlay = None

        if self.serial.connected:
            self._awaiting_light_end = True
            self.root.after(200, lambda: self.send(protocol.CMD_LIGHT))

    def target_samples(self) -> int:
        try:
            return max(1, int(self.target_var.get()))
        except (tk.TclError, ValueError):
            self.target_var.set(50)
            return 50

    def test_sample_count(self) -> int:
        return max(0, len(self.current_samples) - self.test_start_index)

    # ================================================================== runs ==
    def generate_run_name(self) -> str:
        bits = []
        if self.polling_var.get().strip():
            bits.append(f"{self.polling_var.get().strip()} Hz")
        if self.mode_var.get().strip():
            bits.append(self.mode_var.get().strip())
        bits.append(datetime.now().strftime("%Y-%m-%d %H-%M"))
        return " - ".join(bits)

    def current_metadata(self) -> dict:
        device_name = self.device_var.get().strip()
        device_id = self.device_name_to_id.get(device_name)
        if not device_id:
            raise ValueError(tr("dlg.select_device"))

        name = self.run_name_var.get().strip() or self.generate_run_name()
        self.run_name_var.set(name)

        return {
            "device_id": device_id,
            "name": name,
            "polling_rate_hz": _as_int(self.polling_var.get()),
            "connection_mode": self.mode_var.get().strip(),
            "dpi": _as_int(self.dpi_var.get()),
            "mouse_firmware": self.mouse_fw_var.get().strip(),
            "debounce_setting": self.debounce_var.get().strip(),
            "notes": self.live_view.get_notes(),
            "target_samples": self.target_samples(),
            "calibration_us": self.calibration_us(),
            "teensy_firmware": self.serial.firmware_version or "",
            "is_demo": 1 if self.is_demo else 0,
            "mode": self.measure_mode_var.get(),
            "optical_dark": self.optical_dark if self.photon_mode else None,
            "optical_bright": self.optical_bright if self.photon_mode else None,
            "optical_threshold": self.optical_threshold if self.photon_mode else None,
            "target_fps": self.effective_frame_cap() if self.photon_mode else None,
            "light_start": self.light_start,
            "light_end": self.light_end if self.light_end is not None else self.current_light,
            "started_at": self.run_started_at or datetime.now().isoformat(timespec="seconds"),
            "ended_at": self.run_ended_at or datetime.now().isoformat(timespec="seconds"),
        }

    def calibration_us(self) -> int:
        try:
            return int(float(self.cal_var.get().replace("µs", "").strip()))
        except ValueError:
            return 0

    def save_current_run(self) -> None:
        if self.test_mode:
            messagebox.showinfo(tr("dlg.save_session"), tr("dlg.exit_test_first"))
            return
        if not self.current_samples:
            messagebox.showinfo(tr("dlg.save_session"), tr("dlg.no_samples"))
            return
        if self.session_saved:
            messagebox.showinfo(tr("dlg.save_session"), tr("dlg.already_saved"))
            return
        try:
            metadata = self.current_metadata()
        except ValueError as exc:
            messagebox.showwarning(tr("dlg.save_session"), str(exc))
            return

        run_id = self.db.save_run(metadata, self.current_samples)
        self.session_saved = True
        self.log(tr("log.saved", id=run_id))
        self.refresh_sessions()
        self.remember_last_run_settings()
        messagebox.showinfo(tr("dlg.save_session"), tr("dlg.saved", id=run_id))

    def new_run(self) -> None:
        if self.test_mode:
            return
        if self.current_samples and not self.session_saved:
            if not messagebox.askyesno(tr("dlg.new_run"), tr("dlg.discard_confirm")):
                return
        if self.serial.connected:
            self.send(protocol.CMD_RESET)
        else:
            self.clear_samples()
        self.run_name_var.set("")
        self.run_started_at = None
        self.run_ended_at = None
        self.light_start = self.current_light
        self.light_end = None
        self.session_saved = False
        self.remember_last_run_settings()

    def load_template(self, run) -> None:
        """Fill the live configuration from a stored run, samples excluded."""
        device = self.db.get_device(run["device_id"])
        if device:
            self.device_var.set(device["name"])
        self.run_name_var.set(f"{run['name']} (copy)")
        self.polling_var.set(str(run["polling_rate_hz"] or ""))
        self.mode_var.set(run["connection_mode"] or "")
        self.dpi_var.set(str(run["dpi"] or ""))
        self.mouse_fw_var.set(run["mouse_firmware"] or "")
        self.debounce_var.set(run["debounce_setting"] or "")
        self.target_var.set(int(run["target_samples"] or 50))
        self.live_view.set_notes(run["notes"] or "")
        self.notebook.select(self.live_view)
        messagebox.showinfo(tr("tab.sessions"), tr("sessions.template_loaded"))

    def remember_last_run_settings(self) -> None:
        self.settings.update(
            last_polling_rate=self.polling_var.get().strip(),
            last_connection_mode=self.mode_var.get().strip(),
            last_dpi=self.dpi_var.get().strip(),
            target_samples=self.target_samples(),
            auto_reset_on_test=bool(self.auto_reset_var.get()),
            measurement_mode=self.measure_mode_var.get(),
            confirm_btn2_reset=bool(self.confirm_btn2_var.get()),
            frame_cap=self.frame_cap,
            last_device_id=self.device_name_to_id.get(self.device_var.get().strip()),
        )
        self.settings.save()

    def export_current_csv(self) -> None:
        if not self.current_samples:
            messagebox.showinfo(tr("dlg.csv"), tr("dlg.csv_empty"))
            return
        try:
            metadata = self.current_metadata()
        except ValueError:
            metadata = {"name": self.run_name_var.get()}
        path = filedialog.asksaveasfilename(
            defaultextension=".csv",
            initialfile=f"latency_{datetime.now().strftime('%Y%m%d_%H%M%S')}.csv",
            filetypes=[(tr("dlg.csv"), "*.csv"), (tr("dlg.all_files"), "*.*")],
        )
        if not path:
            return
        export.write_csv(path, metadata, self.current_samples,
                         device_name=self.device_var.get().strip())
        self.log(tr("log.csv", path=path))

    # =============================================================== refresh ==
    def refresh_devices(self) -> None:
        devices = self.db.list_devices()
        if not devices:
            self.db.create_device(name="Mouse")
            devices = self.db.list_devices()

        previous = self.device_var.get()
        self.device_name_to_id = {row["name"]: row["id"] for row in devices}
        names = list(self.device_name_to_id)
        self.live_view.set_device_choices(names)

        remembered = self.settings.get("last_device_id")
        by_id = {row["id"]: row["name"] for row in devices}
        if previous in names:
            self.device_var.set(previous)
        elif remembered in by_id:
            self.device_var.set(by_id[remembered])
        elif names:
            self.device_var.set(names[0])

        self.devices_view.reload(devices)

    def auto_select_device(self) -> None:
        """Pick the profile saved for the mouse that is physically connected.

        Only ever *selects* an existing profile; it never creates or edits one.
        """
        try:
            from . import devices as hardware

            for mouse in hardware.detect_mice():
                row = self.db.find_device_by_hardware_id(mouse.hardware_id)
                if row is not None:
                    self.device_var.set(row["name"])
                    self.log(tr("devices.matched", name=row["name"]))
                    return
        except Exception:
            log.debug("device auto-selection failed", exc_info=True)

    def refresh_sessions(self) -> None:
        self.sessions_view.reload()
        self.compare_view.reload()

    def _latencies(self) -> list[float]:
        return [s["latency_ms"] for s in self.current_samples]

    def _record_sample(self, payload: dict, raw_optical: int | None = None) -> None:
        """Store one finished measurement.  Shared by both modes on purpose:
        the archive, the metrics and the test-mode target must behave
        identically whichever path produced the number."""
        sample = {
            "latency_ms": payload["latency_ms"],
            "timestamp": datetime.now().isoformat(timespec="milliseconds"),
        }
        if raw_optical is not None:
            sample["raw_optical"] = raw_optical
        self.current_samples.append(sample)
        self.session_saved = False
        self._update_metrics()
        self.state_var.set("PHOTON" if self.photon_mode else "READY")

        if self.test_mode and self.test_sample_count() >= self.target_samples():
            self.test_complete = True
            if self.overlay:
                self.overlay.set_mode("complete")

    def clear_samples(self) -> None:
        self.current_samples.clear()
        self.session_saved = False
        self._update_metrics()

    def _update_metrics(self) -> None:
        values = self._latencies()
        stats = compute_stats(values)
        self.metric_vars["n"].set(str(stats["n"]))
        if not values:
            for key, var in self.metric_vars.items():
                if key != "n":
                    var.set("—")
            self.outlier_var.set("")
        else:
            self.metric_vars["last"].set(fmt_ms(values[-1]))
            for key in ("mean", "median", "min", "max", "stdev",
                        "p5", "p95", "p99", "iqr", "mad", "jitter"):
                self.metric_vars[key].set(fmt_ms(stats[key]))
            from .stats import outlier_indices
            count = len(outlier_indices(values))
            self.outlier_var.set(tr("live.outliers", count=count) if count else "")
        self.live_view.set_samples(values)

    def log(self, message: str) -> None:
        self.live_view.log(f"[{datetime.now():%H:%M:%S}] {message}")

    # ============================================================ event pump ==
    def _pump(self) -> None:
        while True:
            try:
                event = self.serial.events.get_nowait()
            except queue.Empty:
                break
            try:
                self._handle(event)
            except Exception:
                log.exception("error while handling %s", event.kind)
        if self.overlay is not None:
            self.overlay.refresh()
        if self.running:
            self._timers["pump"] = self.root.after(PUMP_INTERVAL_MS, self._pump)

    def _handle(self, event: protocol.Event) -> None:
        kind, payload = event.kind, event.payload

        if kind == "latency":
            # Probe-to-PC only.  An optical result arrives as "optical" and is
            # never mistaken for one of these.
            self._record_sample(payload)
            self.log(tr("log.latency", value=f"{payload['latency_ms']:.3f}"))
            if not self.test_mode:
                self.root.after(
                    150, lambda: self.send(protocol.CMD_LIGHT) if self.serial.connected else None)

        elif kind == "optical":
            self._record_sample(payload, raw_optical=payload["raw_optical"])
            self.log(tr("log.optical", value=f"{payload['latency_ms']:.3f}",
                        raw=payload["raw_optical"]))

        elif kind == "optical_cal":
            self._apply_optical_cal(payload)
            self.log(tr("log.optical_cal", dark=payload["dark"],
                        bright=payload["bright"], threshold=payload["threshold"]))

        elif kind == "optical_timeout":
            self.state_var.set("OPT T/O")
            self.log(tr("log.optical_timeout"))

        elif kind == "optical_error":
            self.state_var.set("OPT ERR")
            self.log(tr("log.optical_error", reason=payload))

        elif kind == "optical_drop":
            self.log(tr("log.optical_drop", value=fmt_ms(payload)))

        elif kind == "photon_on":
            self.state_var.set("PHOTON")
            self.log(tr("log.photon_on"))

        elif kind == "photon_off":
            self.state_var.set("READY")
            self.log(tr("log.photon_off"))

        elif kind == "stats":
            self.cal_var.set(f"{payload['calib']} µs")

        elif kind == "cal_ok":
            self.cal_var.set(f"{payload['calib']} µs")
            self.state_var.set("READY")
            self.log(tr("log.calibrated", calib=payload["calib"],
                        samples=payload["samples"], avg=payload["avg_rt"]))

        elif kind == "cal_fail":
            self.state_var.set("CAL FAIL")
            self.log(tr("log.calib_failed"))

        elif kind == "light":
            self.current_light = payload
            self.light_var.set(str(payload))
            if self.light_start is None and not self.test_mode:
                self.light_start = payload
            if self._awaiting_light_end:
                self.light_end = payload
                self._awaiting_light_end = False

        elif kind == "reset":
            self.clear_samples()
            self.state_var.set("READY")
            self.log(tr("log.reset"))

        elif kind == "skip_oled":
            self.skipped_var.set(str(_as_int(self.skipped_var.get(), 0) + 1))
            self.log(tr("log.skip"))
            if self.test_mode and not self.test_complete and self.overlay:
                self.overlay.set_mode("wait")

        elif kind == "armed":
            self.state_var.set("ARMED")
            if self.test_mode and not self.test_complete and self.overlay:
                self.overlay.set_mode("armed")

        elif kind == "rearm":
            self.state_var.set("REARM")
            if self.test_mode and not self.test_complete and self.overlay:
                self.overlay.set_mode("wait")

        elif kind == "trig":
            self.state_var.set("TRIG")
            if self.test_mode and not self.test_complete and self.overlay:
                self.overlay.set_mode("wait")

        elif kind == "trig_unmatched":
            self.log(tr("log.trig_unmatched"))

        elif kind == "testmode_on":
            self.state_var.set("TEST MODE")
            self.log(tr("log.testmode_on"))

        elif kind == "testmode_off":
            self.state_var.set("READY")
            self.log(tr("log.testmode_off"))

        elif kind == "abort":
            self.log(tr("log.abort"))

        elif kind == "drop":
            self.log(tr("log.drop", value=fmt_ms(payload)))

        elif kind == "button":
            index = payload["index"]
            if index in self.button_counts:
                self.button_counts[index] += 1
                self.button_vars[index].set(str(self.button_counts[index]))
            self.log(payload["token"])
            if payload["action"] == "PRESS":
                self._button_action(index)

        elif kind == "banner":
            self.firmware_var.set(payload)
            if payload and payload not in SUPPORTED_FIRMWARE and not self.serial.is_demo:
                self.log(tr("conn.firmware_mismatch", found=payload,
                            expected="/".join(SUPPORTED_FIRMWARE)))

        elif kind == "ready":
            self.state_var.set("READY")

        elif kind == "timeout":
            self.state_var.set("TIMEOUT")
            self.log(payload)

        elif kind == "serial_error":
            self.log(tr("conn.lost", error=payload))
            self.disconnect(keep_retrying=True)

        elif kind in ("log", "oled_ok", "oled_fail", "stats_no_data",
                      "calibrating", "pc_synced", "await_sync"):
            if payload:
                self.log(str(payload))

    def _poll_light(self) -> None:
        if (self.running and self.serial.connected and not self.test_mode
                and not self.serial.calibrating):
            self.send(protocol.CMD_LIGHT)
        if self.running:
            # While the optical target is on screen the reading is an aiming
            # instrument, and once a second is too slow to see the black and
            # white phases at all.  Safe to speed up: no measurement is running.
            interval = (LIGHT_AIM_POLL_MS if self.cal_window is not None
                        else LIGHT_POLL_MS)
            self._timers["light"] = self.root.after(interval, self._poll_light)

    # ============================================================== shutdown ==
    def close(self) -> None:
        if self.current_samples and not self.session_saved:
            if not messagebox.askyesno(tr("dlg.close"), tr("dlg.close_confirm")):
                return
        self.running = False
        for timer_id in self._timers.values():
            try:
                self.root.after_cancel(timer_id)
            except tk.TclError:
                log.debug("timer %s was already gone", timer_id)
        self._timers.clear()
        if self.test_mode:
            self.exit_test_mode()
        self.cancel_optical_calibration()

        try:
            self.settings.set("window_geometry", self.root.winfo_geometry())
        except tk.TclError:
            log.debug("no geometry to save; the window is already gone")
        self.remember_last_run_settings()

        self.disconnect()
        self.mouse.stop()
        try:
            self.db.close()
        except Exception:
            log.debug("database close failed", exc_info=True)
        self.root.after(50, self.root.destroy)


def _as_int(value, default=None):
    try:
        return int(str(value).strip())
    except (TypeError, ValueError):
        return default


def main() -> None:
    logging.basicConfig(
        level=logging.INFO,
        format="%(asctime)s %(levelname)-7s %(name)s: %(message)s",
    )
    root = tk.Tk()
    LatencyTesterApp(root)
    root.mainloop()


if __name__ == "__main__":
    main()
