PrimeBuild-pc/MouseLatencyTester/(commit log)

2026-08-19 Add Teensy 2.0 firmware, v1.0 through v1.4
    v1.3 is the verified measurement baseline: probe debounce and re-arm,
    one sample per physical press, OLED frozen during test mode.
    v1.4 adds the BTN1/BTN2 test events on pads B0/B1. The buttons are
    polled in loop() rather than on an interrupt, debounced with a
    non-blocking 30 ms millis() window, and their events are queued and
    only transmitted while no measurement is pending -- so nothing is ever
    written to the port between t0 and t1. The measurement path is
    byte-identical to v1.3.
    Older sketches are kept unmodified for reference.
2026-08-19 Add the dashboard as a modular package with its test suite
    Splits the previous single-file dashboard into GUI-free core modules
    (protocol, statistics, database, serial service, settings, i18n, theme)
    plus tkinter views, so the measurement and serial layers can be tested
    without a display.
    The measurement pipeline is unchanged: TRIG/click association, t0/t1
    handling, the calibration offset, the 2-100 ms filter, debounce/re-arm,
    test mode and the OLED freeze all behave as in the verified v2.
    Adds light/dark/system themes, eight interface languages loaded from
    JSON locale files, device profiles, run metadata editing and templates,
    MAD and outlier marking (marked, never removed), baseline comp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
2026-08-19 Add hardware and protocol documentation
    Serial protocol reference covering every token read from the firmware
    source, the Windows install guide, Teensy flashing, the ten-step
    bring-up procedure with expected values, first measurement walkthrough
    and troubleshooting.
    Documents the calibration echo quirk deliberately left unchanged: the
    PC sends a two-byte reply where the firmware reads one, which collapses
    the offset towards its +250 us constant. Every archived measurement was
    taken with this behaviour, so changing it would shift all values.
2026-08-19 ci: bump all actions to current majors
    Clears the Node 20 deprecation warning on the runners. Supersedes the
    Dependabot pull requests #1 through #5.
2026-08-19 Renumber to 1.0.0, add one-click updater, 8-language locales and a proper README
    The published series starts at 1.0.0: the earlier numbering came from internal
    single-file iterations that were never released, and carrying it into the first
    public tag was misleading.
    Updater
    - Settings gains a checked update that reads the project's GitHub releases,
    downloads the installer and runs it, then closes the app so files can be
    replaced.
    - The repository is hard-coded, only HTTPS GitHub hosts are accepted, and the
    download is verified against the release's SHA256SUMS.txt before anything is
    executed. A mismatch, a missing checksum line, or a release with no published
    checksum deletes the f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
    [updater.py]
2026-08-19 Identify the connected mouse and measure its real polling rate
    Devices gains a Detect button that reads the USB string descriptors of the
    connected mouse and fills in the profile name, manufacturer and serial. The
    registry is not used for this: it only ever reports the generic INF name
    "HID-compliant mouse", so HidD_GetProductString and friends are queried
    directly. Where several devices expose a mouse collection -- a keyboard with
    mouse emulation, for example -- a picker is shown rather than guessing.
    Schema v2 adds devices.hardware_id (VID:PID), so a profile stays attached to
    its physical mouse. Plugging a known mouse in selects its profile at startup.
    The name is the user's to change; th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
2026-08-19 ci: run the coverage gate on Windows only
    devices.py is a Win32 implementation and cannot execute on Linux, so the
    Ubuntu job measured it at 32% and dragged the total under the 85% floor. The
    test suite itself still runs on both platforms and passes on both; only the
    coverage threshold moves to where the platform code can actually be exercised.
2026-08-19 Address the CodeQL quality alerts
    None of the 49 alerts were security findings: they all come from the
    security-and-quality suite, which also reports maintainability issues.
    Fixed for real:
    - compare.py compared a value with itself to test for NaN, which is an
    idiom obscure enough that CodeQL flagged it as a likely bug. It now uses
    math.isnan and says what it means.
    - app.py imported 'database' without using it.
    - A test helper caught bare Exception while draining a queue, which would
    have hidden a genuine failure as a timeout. It now catches queue.Empty.
    - Ten 'except tk.TclError: pass' blocks now log at debug level instead of
    swallowing silently. Behaviour is unchanged -- every on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
    [app.py, theme.py, widgets.py]
2026-08-20 Add an 'in development' typewriter banner to the README
    Self-hosted animated SVG rather than a third-party typing service, so no
    external host sits between a reader and the README. GitHub does not run
    JavaScript in READMEs but does render animated SVG, so the effect is SMIL
    plus inline CSS.
    The reveal is a clip rectangle stepped one character at a time. The text
    carries an explicit textLength, which pins the character width regardless of
    which monospace font the reader has installed -- without it a font fallback
    would drift the caret away from the text. Colours switch on
    prefers-color-scheme and the default is legible on both themes.
2026-08-21 Probe-to-Photon, buttons bound, live-tab layout fixed (#7)
    * Add Probe-to-Photon, bind the buttons, fix the live-tab layout
    Firmware v1.5 (firmware/latency_tester_photon_v1_5/) adds a second,
    separate measurement mode. The Probe-to-PC path is byte-identical to
    v1.4 and v1.3: probeISR(), the t0/t1 block, the TRIG/'H' handshake,
    runCalibration(), serviceProbeRearm(), every filter and the OLED freeze
    are untouched. The diff from v1.4 removes six lines: three version
    strings, one comment, the `if (probeFlag)` that became
    `} else if (probeFlag)`, and the OLED refresh guard that now also checks
    the optical mode.
    Probe-to-Photon: t0 is the same probe contact on D2, t1 is the first A0
    reading past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
    [app.py, constants.py, database.py, demo.py, latency_tester_photon_v1_5.ino]
2026-08-21 Drop the unused parts from the specification; plan the next three steps
    The 2N2222A and the 220 ohm resistors are out of the BOM, the wiring
    tables, both diagrams, the bring-up list and the protocol notes. Keeping
    them as a struck-through "not needed" row still made a reader stop and
    work out whether they were missing a step. The changelog is the only
    record that keeps them, which is what a changelog is for.
    Also fixes a stale section: serial_protocol.md still listed
    Probe-to-Photon under "Not implemented" two sections above the sequence
    diagram that documents it working.
    Roadmap now covers the four things that are actually next, with the
    reasoning for each:
    - The enclosure, including a p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
2026-08-21 Add a frame cap on the optical target; design the photodiode front-end
    The optical target now changes only on a frame boundary, so the wait for
    the next frame is measured instead of assumed -- on average half a frame.
    30/60/120/240/360/500/1000 fps or "Monitor", which follows the refresh
    rate Windows reports, chosen per test in the optical panel.
    One timer drives both the input check and the repaint, which is how a
    game loop works: input at the start of a frame, present at the end. The
    schedule aims at an absolute deadline rather than adding a rounded
    interval each tick, so 360 fps averages 2.78 ms instead of drifting 8% on
    the 3 ms rounding.
    Schema v4 stores runs.target_fps. Without it an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
    [app.py, constants.py, database.py, devices.py, settings.py]
2026-11-11 Add the compact A1b PCB: KiCad project, fabrication files, checks and docs
    Compact 56 x 48 mm two-layer board (BPV10 + OPA380 + TLV3501 on a Teensy 2.0),
    revision A1b. ERC/DRC and schematic-to-board comparison pass; the board is not
    built or tested yet. Includes the PCBWay Gerber package and a portable KiCad 9
    copy under outputs/, plus the hardware research notes.
2026-11-11 Add 3D renders of the A1b PCB and its STEP model
    Four KiCad renders (iso top/bottom, flat top/bottom) in docs/images/hardware,
    shown in the README as renders of the unbuilt design. The STEP export in
    hardware/compact/mechanical is the starting point for the enclosure.
    hardware/compact/render_3d.py regenerates both from a copy of the board.
